BondtechAB/Voron/Voron_2.4-VT-SW/CPAP/README.md

# CPAP for Voron 2.4 and Stealthburner





## INSTRUCTIONS

Print in ASA or ABS

## BOM

*   3x M3x35 BHCS OR SHCS
*   2x M3x8 BHCS OR SHCS
*   2x M3x12 BHCS OR SHCS
*   2x M2x10 BHCS OR SHCS self tapping
*   7x M3x4 heatset insert
*   WS7040 and 15 mm CPAP hose
*   PC4-M10 Passthrough push fit connector
*   Some CA glue to attach the bowden passthrough

Thank you to criticaldistance for laying the foundation for the toolhead mod and giving me great ideas for implementation.

Also thanks to ByThorsThunder who made the elongated front for the SB. Find that here: https://github.com/VoronDesign/VoronUsers/tree/master/printer_mods/bythorsthunder/Stealthburner_Rapido_Uhf
