BondtechAB/Voron/Voron_2.4-VT-SW/LGX_lite/STL/SB _MOS/README.md

# Mosquito and Mosquito Magnum+ module

This contains custom x-carriages with our without square nut inserts, with native support for euclid and compatible with Voron Tap.







You can find the elongated SB front for Mosquito Magnum+ here, it's shared and compatible with Rapido UHF front: https://github.com/VoronDesign/VoronUsers/tree/master/printer_mods/bythorsthunder/Stealthburner_Rapido_Uhf

For the normal Mosquito you can use the standard SB front or variations thereof.

For use of Mosquito Magnum+ it's highly adviseable to use insulation around all sides of the block. In the directory SB_MOS-PLUS_SOCK you can find moulds for the block top and bottom. This may work printed with FDM, but for best results print with a resin printer and coat the resin to seal it in order to not inhibit the silicone curing.
