BondtechAB/Voron/Voron_2.4-VT-SW/LGX_lite/STL/SB-LGX_lite-Ebb36/README.md

# EBB36 module



## BOM

*   5x heatset inserts
*   2x M3x8 BHCS or SHCS
*   2x M3x30 BHCS or SHCS
*   1x M2x10 self tapping SHCS
*   1-2x PG7 spiral gland for CAN wiring
*   Optional 2510 24v fan with 4x M3x6. Tap the fan screw holes with an M3 tap, or let the screws cut threads. Source it from here: https://www.bondtech.se/product/mosquito-24v-fan-with-xhp-2-plug/
