BondtechAB/Voron/Voron_2.4-VT-SW/CPAP/STL frame/pcb holder.stl

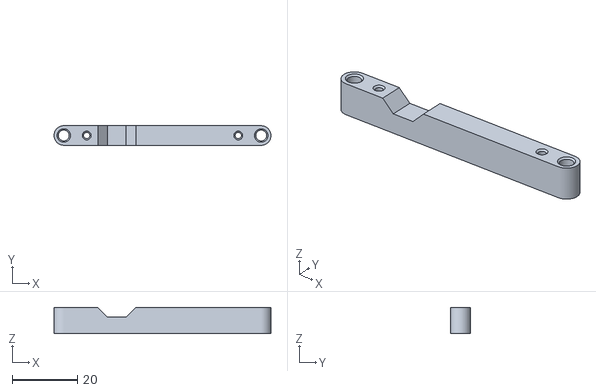
[picture p2: CAD file, 2024-01-02]
Voron_2.4-VT-SW/CPAP/STL frame/pcb holder.stl
66.3 x 6.01 x 8.00
