BondtechAB/Voron/Voron_2.4-VT-SW/LGX_lite/CAD/SB_MOS-PLUS_SOCK.step

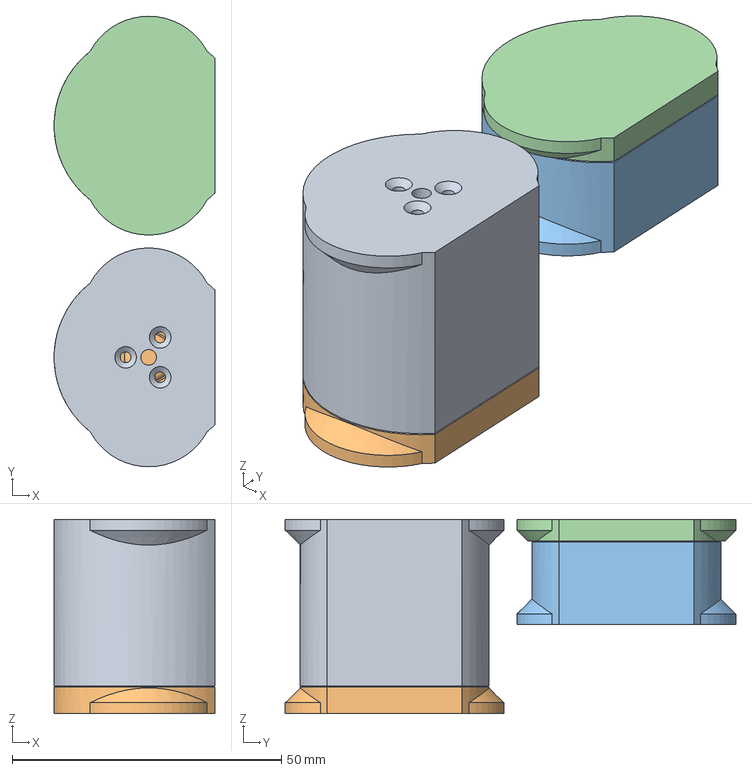
[picture p3: CAD file, 2024-01-09]
Voron_2.4-VT-SW/LGX_lite/CAD/SB_MOS-PLUS_SOCK.step
29.9 x 83.6 x 36.0 mm
