BondtechAB/Voron/Voron_2.4-VT-SW/LGX_lite/STL/LGX_lite-CW2-SB/lever_extender.stl

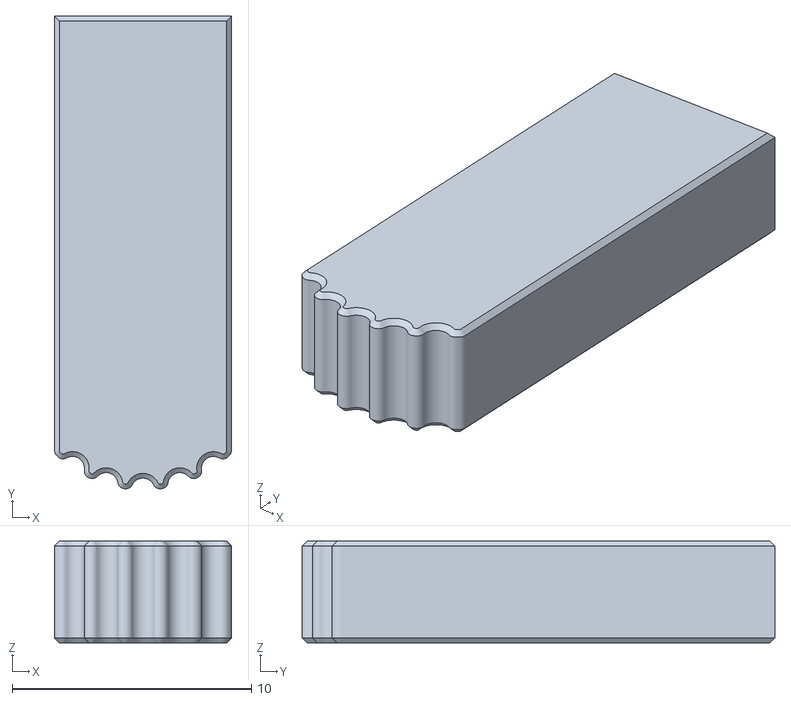
[picture p4: CAD file, 2024-01-09]
Voron_2.4-VT-SW/LGX_lite/STL/LGX_lite-CW2-SB/lever_extender.stl
7.40 x 19.8 x 4.25
