BondtechAB/Voron/Voron_2.4-VT-SW/LGX_lite/STL/SB _MOS/SB_MOS_Rear_CW2.stl

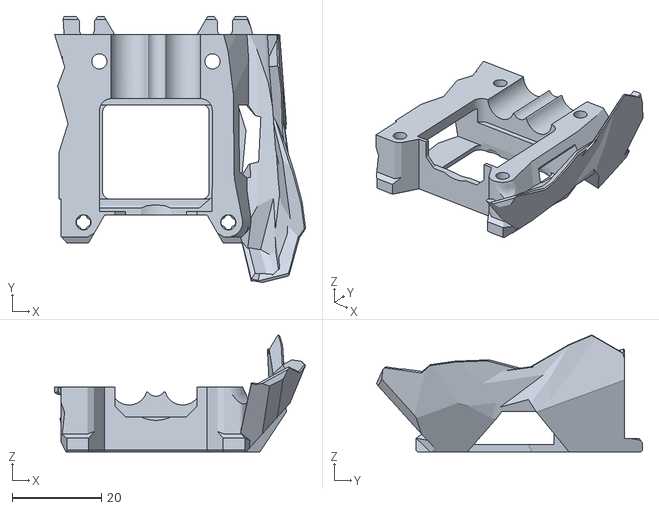
[picture p6: CAD file, 2024-01-02]
Voron_2.4-VT-SW/LGX_lite/STL/SB _MOS/SB_MOS_Rear_CW2.stl
56.3 x 59.7 x 26.3
