BondtechAB/Voron/Voron_2.4-VT-SW/CPAP/STL frame/back-cover.stl

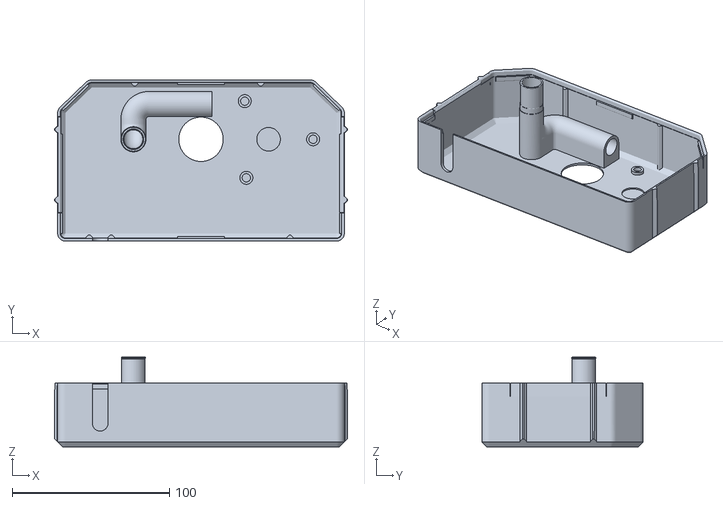
[picture p7: CAD file, 2024-01-02]
Voron_2.4-VT-SW/CPAP/STL frame/back-cover.stl
186.4 x 102.6 x 57.0
