BondtechAB/Voron/Voron_2.4-VT-SW/LGX_lite/CAD/LGX_lite-CW2-SB_FDM.step

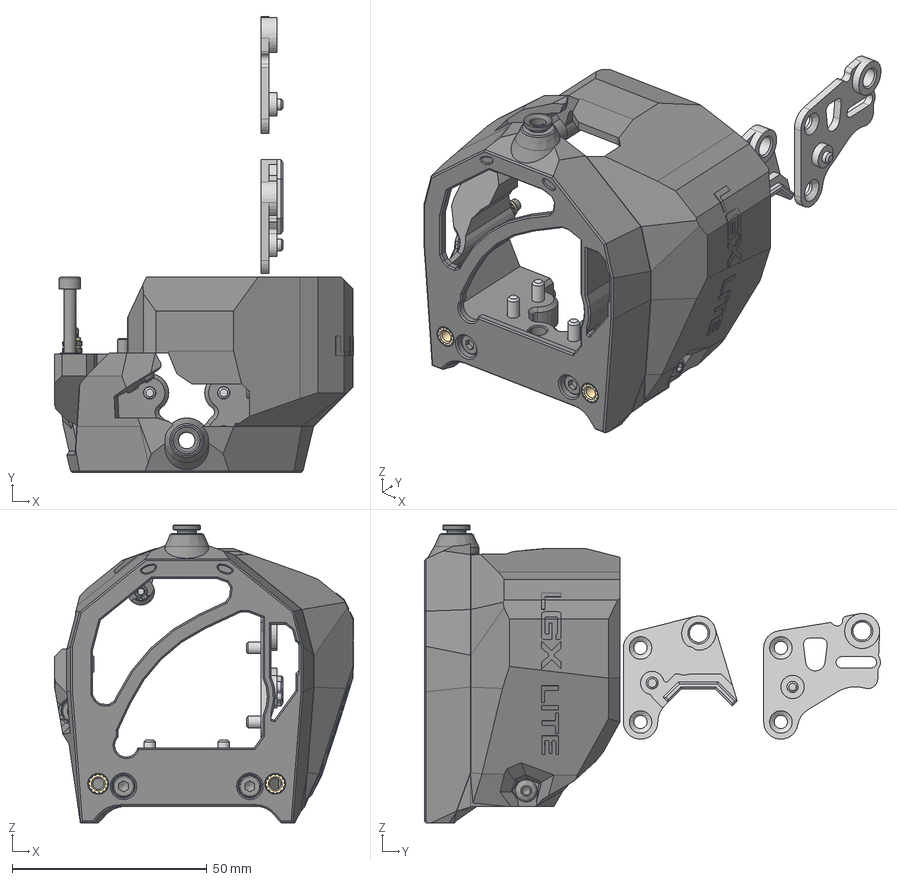
[picture p8: CAD file, 2024-01-02]
Voron_2.4-VT-SW/LGX_lite/CAD/LGX_lite-CW2-SB_FDM.step
76.8 x 117.0 x 76.3 mm
Collet
Hartk CW2 AB pcb mount
Hartk CW2 SB pcb mount
Hartk CW2 AB ERCF pcb mount
M3 Threaded Insert x 8
M3x30_SHCS (1) x 2
M3x8_SHCS
M3x16_SHCS x 2
ISO 7380-1 - M3 x 6
M3x20_SHCS
M3x30_SHCS
M3x6_FHCS x 2
M3x12_SHCS x 4
M3x6_SHCS
M3x10_SHCS
10100-05_StealthBurner_Main_Body_FDM
10100-06 StealthBurner PCB Cover
92605A114_NO THREADS_Stainless Steel Flat-Tip Set Screw
