BondtechAB/Voron/Voron_2.4-VT-SW/LGX_lite/STL/SB _MOS/x_frame_V2TR-mosquito_MGN12_left.stl

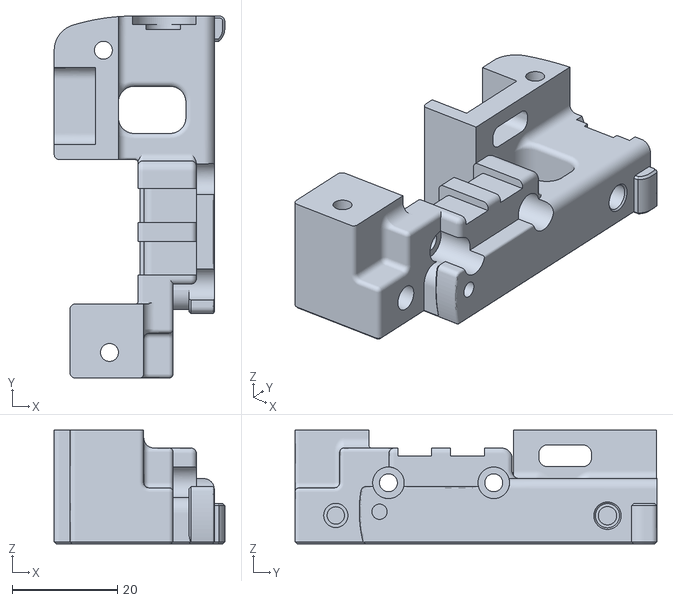
[picture p10: CAD file, 2024-01-02]
Voron_2.4-VT-SW/LGX_lite/STL/SB _MOS/x_frame_V2TR-mosquito_MGN12_left.stl
32.4 x 68.8 x 21.6
