BondtechAB/Voron/Voron_2.4-VT-SW/CPAP/STL frame/Cover.stl

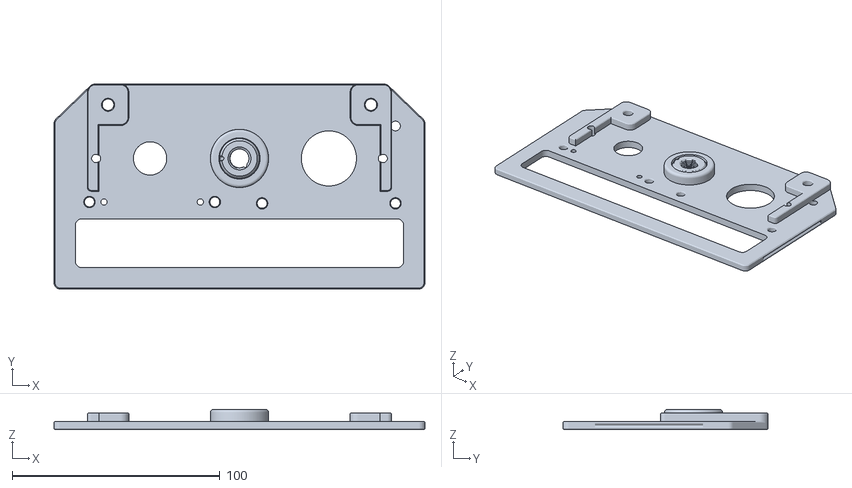
[picture p11: CAD file, 2024-01-02]
Voron_2.4-VT-SW/CPAP/STL frame/Cover.stl
178.4 x 98.6 x 9.70
