BondtechAB/Voron/Voron_2.4-VT-SW/LGX_lite/STL/SB-LGX_lite-Ebb36/Bondtech-ebb36_spacer_x2.stl

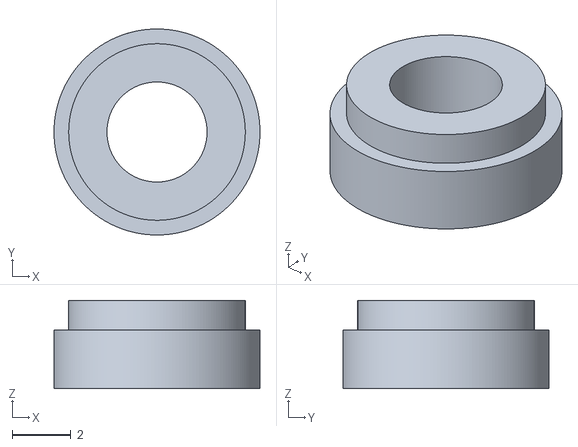
[picture p14: CAD file, 2023-01-23]
Voron_2.4-VT-SW/LGX_lite/STL/SB-LGX_lite-Ebb36/Bondtech-ebb36_spacer_x2.stl
7.00 x 7.00 x 3.00
