BondtechAB/Voron/Voron_2.4-VT-SW/CPAP/STL frame/ptfe-funnel.stl

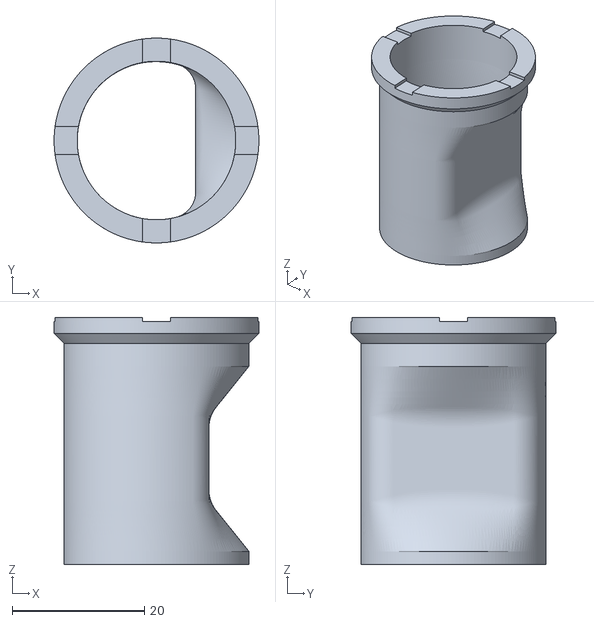
[picture p15: CAD file, 2024-01-02]
Voron_2.4-VT-SW/CPAP/STL frame/ptfe-funnel.stl
31.0 x 31.0 x 37.4
