BondtechAB/Voron/Voron_2.4-VT-SW/CPAP/STL toolhead/SB-CPAP_hose-mount.stl

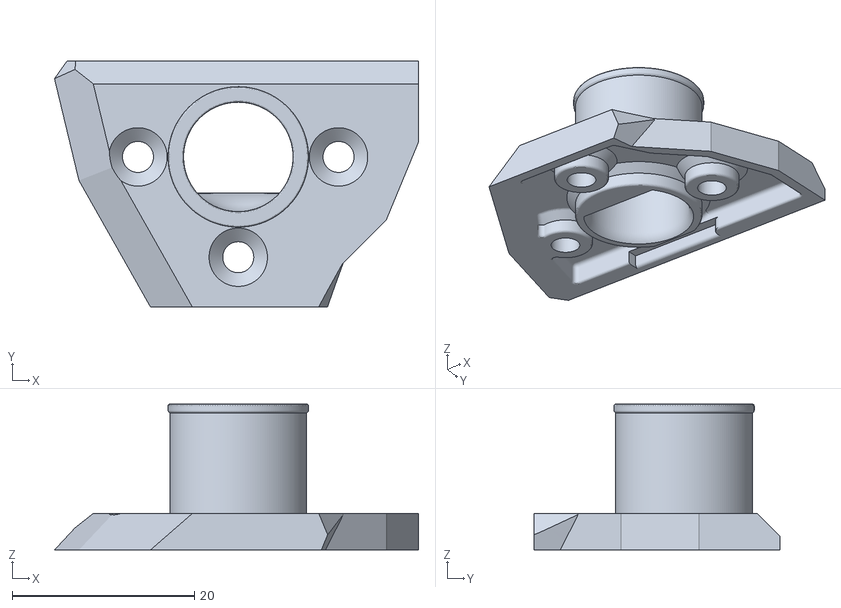
[picture p16: CAD file, 2024-01-02]
Voron_2.4-VT-SW/CPAP/STL toolhead/SB-CPAP_hose-mount.stl
39.9 x 27.0 x 16.0
