BondtechAB/Voron/Voron_2.4-VT-SW/LGX_lite/STL/SB _MOS/SB _MOS-PLUS_Front.stl

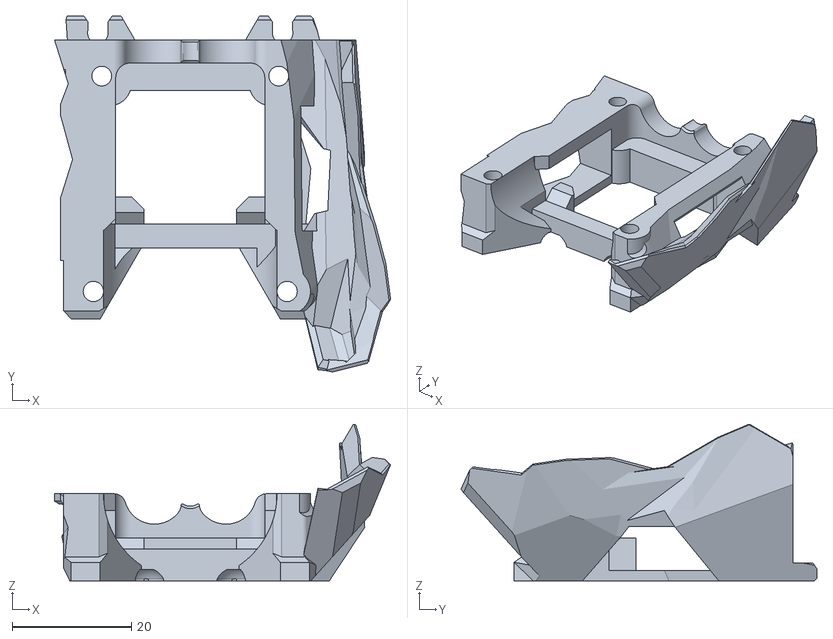
[picture p17: CAD file, 2023-01-23]
Voron_2.4-VT-SW/LGX_lite/STL/SB _MOS/SB _MOS-PLUS_Front.stl
56.4 x 59.7 x 26.3
