BondtechAB/Voron/Voron_2.4-VT-SW/LGX_lite/STL/SB _MOS/SB_MOS-PLUS_SOCK/SB_MOS-PLUS_SOCK_TOP_SHAPE.stl

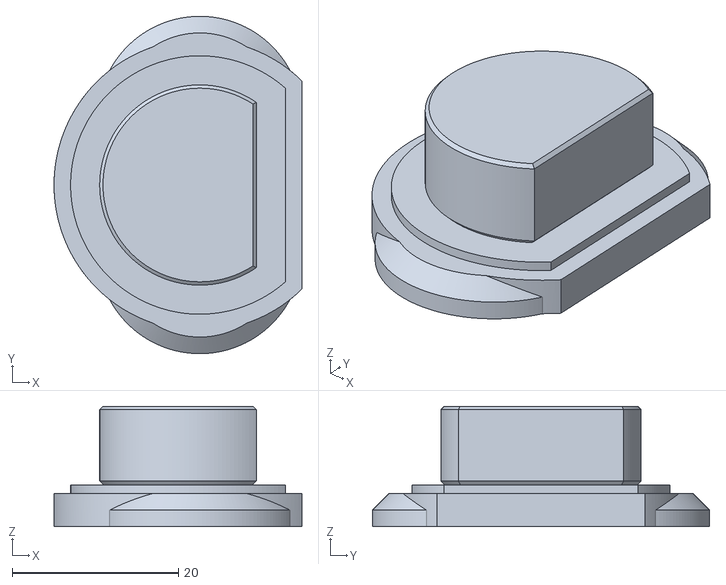
[picture p18: CAD file, 2024-01-09]
Voron_2.4-VT-SW/LGX_lite/STL/SB _MOS/SB_MOS-PLUS_SOCK/SB_MOS-PLUS_SOCK_TOP_SHAPE.stl
29.9 x 40.6 x 14.5
