BondtechAB/Voron/Voron_2.4-VT-SW/CPAP/STL frame/Grill.stl

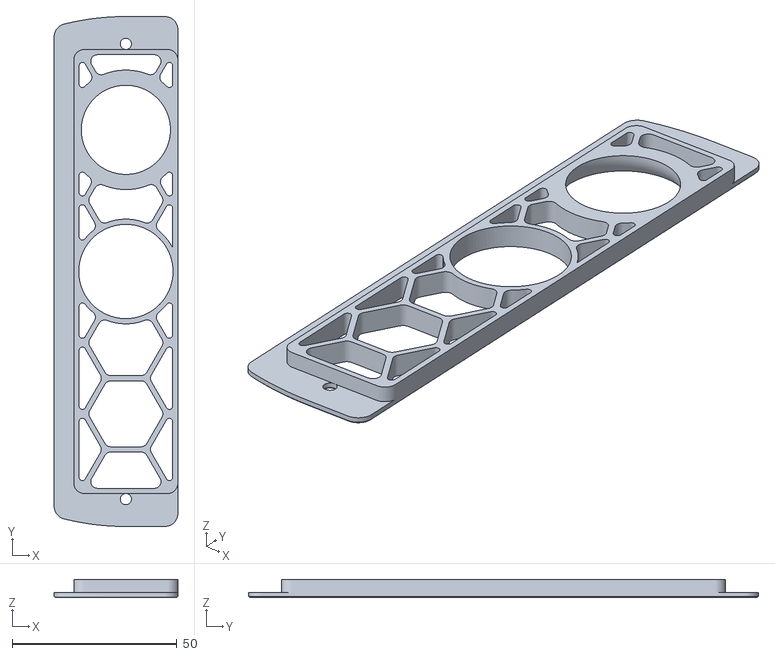
[picture p19: CAD file, 2024-01-02]
Voron_2.4-VT-SW/CPAP/STL frame/Grill.stl
37.6 x 154.8 x 5.60
