BondtechAB/Voron/Voron_2.4-VT-SW/LGX_lite/STL/LGX_lite-CW2-SB/Hartk_CW2_AB_ERCF_pcb_mount.stl

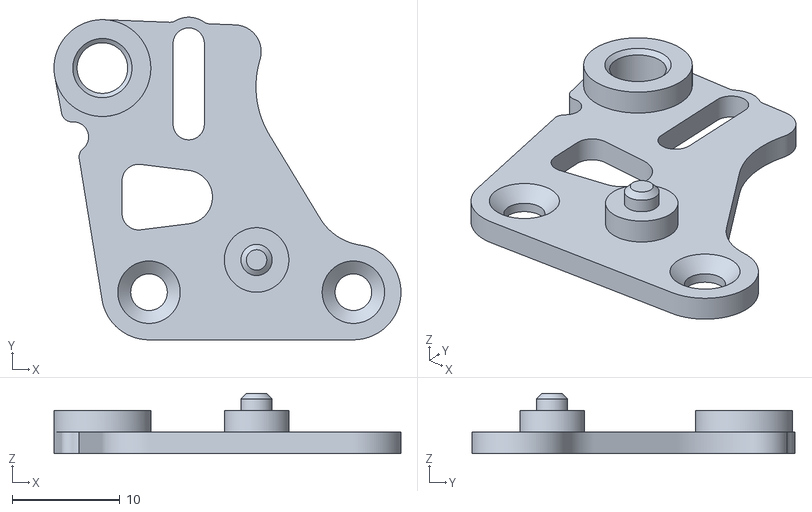
[picture p20: CAD file, 2023-01-23]
Voron_2.4-VT-SW/LGX_lite/STL/LGX_lite-CW2-SB/Hartk_CW2_AB_ERCF_pcb_mount.stl
32.3 x 30.0 x 5.60
