BondtechAB/Voron/Voron_2.4-VT-SW/LGX_lite/STL/SB _MOS/euclid_probe_mount.stl

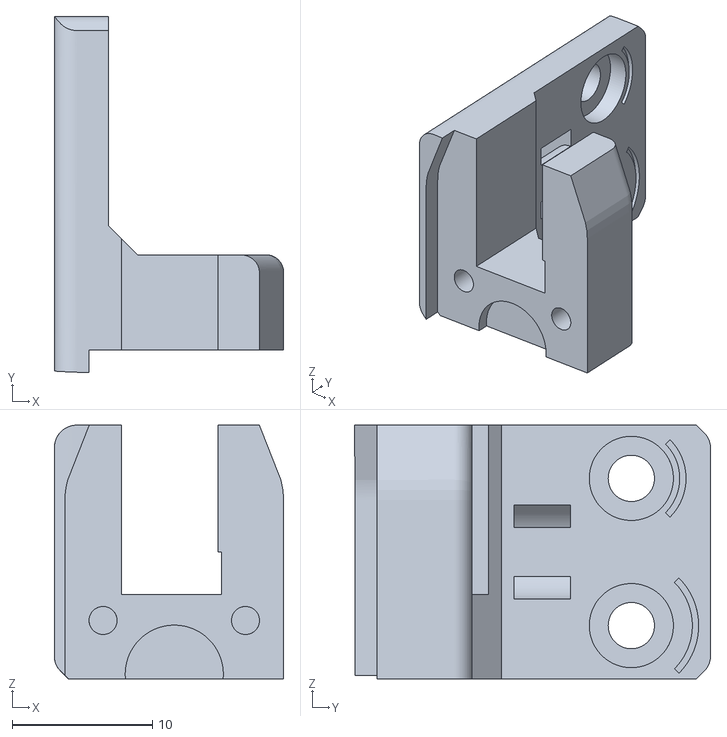
[picture p22: CAD file, 2023-01-23]
Voron_2.4-VT-SW/LGX_lite/STL/SB _MOS/euclid_probe_mount.stl
16.4 x 25.4 x 18.1
