BondtechAB/Voron/Voron_2.4-VT-SW/LGX_lite/STL/LGX_lite-CW2-SB/Hartk_CW2_SB_pcb_mount.stl

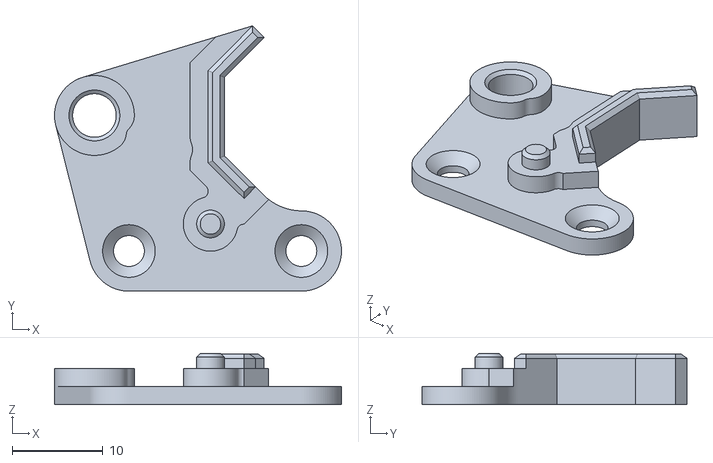
[picture p23: CAD file, 2023-01-23]
Voron_2.4-VT-SW/LGX_lite/STL/LGX_lite-CW2-SB/Hartk_CW2_SB_pcb_mount.stl
31.6 x 29.2 x 5.65
