BondtechAB/Voron/Voron_2.4-VT-SW/LGX_lite/STL/LGX_lite-CW2-SB/ptfe_cutting_jig.stl

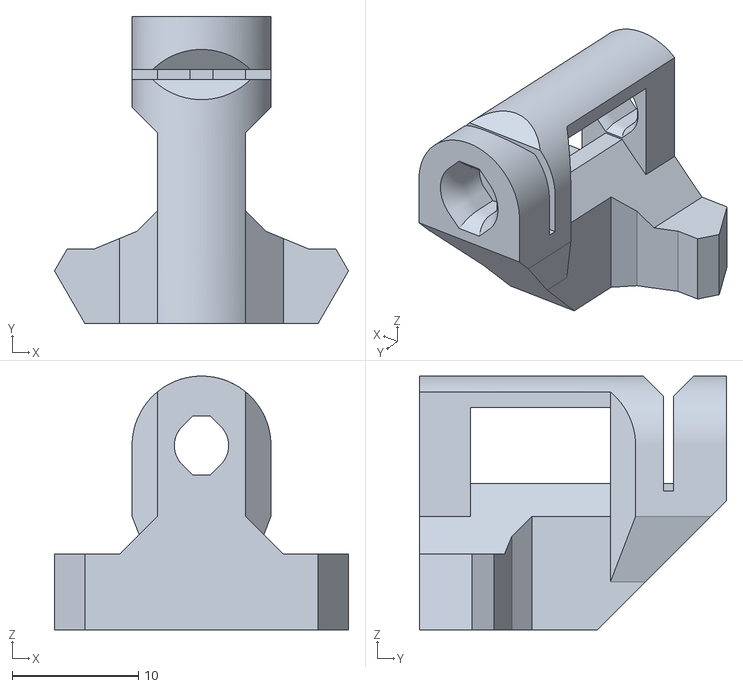
[picture p24: CAD file, 2023-01-23]
Voron_2.4-VT-SW/LGX_lite/STL/LGX_lite-CW2-SB/ptfe_cutting_jig.stl
23.3 x 24.3 x 20.1
