BondtechAB/Voron/(list of files, cad)

Other CAD files:
Voron_2.4-VT-SW/CPAP/STL toolhead/10100-04_StealthBurner_Front_CPAP_MOS-PLUS_FDM.stl
Voron_2.4-VT-SW/CPAP/STL toolhead/10100-19_StealthBurner_Cam_Module.stl
Voron_2.4-VT-SW/CPAP/STL toolhead/10100-20_StealthBurner Cam_Holder.stl
Voron_2.4-VT-SW/CPAP/STL toolhead/10100-22_StealthBurner_CPAP_PCB_Cover.stl
Voron_2.4-VT-SW/LGX_lite/STL/LGX_lite-CW2-SB/10100-05_StealthBurner_Main_Body_FDM.stl
Voron_2.4-VT-SW/LGX_lite/STL/LGX_lite-CW2-SB/10100-06_StealthBurner_PCB_Cover-FDM.stl
Voron_2.4-VT-SW/LGX_lite/STL/LGX_lite-CW2-SB/10100-07_StealthBurner_EBB36 PG7_Mount_nosupport-FDM.stl
Voron_2.4-VT-SW/LGX_lite/STL/LGX_lite-CW2-SB/10100-07_StealthBurner_EBB36 PG7_Mount_supported-FDM.stl
Voron_2.4-VT-SW/LGX_lite/STL/SB _MOS/x_frame_V2TR-mosquito_MGN12_left-square_nut.stl
Voron_2.4-VT-SW/LGX_lite/STL/SB _MOS/x_frame_V2TR-mosquito_MGN12_right-square_nut.stl
Voron_2.4-VT-SW/LGX_lite/STL/SB-LGX_lite-Ebb36/10100-08_StealthBurner_EBB36_PCB_Cover-FDM.stl
Voron_2.4-VT-SW/LGX_lite/STL/SB-LGX_lite-Ebb36/10100-09_StealthBurner_EBB36_PCB_Cover_Back-FDM.stl
