BondtechAB/Voron/(threads)

Thread 1 (2023-01-26):

Missing SB-front_MOS in STEP; Missing STLs for SB-front_MOS and SB-front_MOS-PLUS

eduncan911, 2023-01-26:
First! j/k

For the **LGX Lite for Voron CW2 Stealthburner**, the STEP file is missing the non-CPAP Front cover (I think they should be called "frontcover" instead of "front", as there are two fronts for the PLUS.

https://github.com/BondtechAB/Voron/blob/main/Voron_2.4-VT-SW/LGX_lite/CAD/Bondtech-LGX_lite-stealthburner.step

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

eduncan911, 2023-01-26:
And... It looks like the STLs for both the SB-front_MOS-PLUS, and the reported missing object in OP, are both missing from the STL directory:

https://github.com/BondtechAB/Voron/tree/main/Voron_2.4-VT-SW/LGX_lite/STL/SB%20_MOS

ogland, 2023-01-27:
Hi! Mosquito uses the same cover as standard SB. The SB front is found at the credits: [https://github.com/VoronDesign/VoronUsers/tree/master/printer_mods/bythorsthunder/Stealthburner_Rapido_Uhf](https://github.com/VoronDesign/VoronUsers/tree/master/printer_mods/bythorsthunder/Stealthburner_Rapido_Uhf)

I'll make this more clear in the readme.

eduncan911, 2023-01-27:
Ok, great.  That covers (phun) the non-PLUS.

However, that just leaves the STL export of the PLUS front cover, as originally reported in the OP.

eduncan911, 2023-01-27:
Updated the Title, and 2nd post for what's remaining.

Also, could you re-open until the README is updated and the STL posted?

ogland, 2023-01-27:
The STL won't be uploaded. It's available in the repo linked to in the readme.

Closed 2023-01-27.

Thread 2 (2023-01-26):

[Talk] Design Considerations

eduncan911, 2023-01-26:
Thank you for posting this design.  I've been tinkering with LGX Lite designs, trying to make something work with my custom VolcoMosq setup (which uses the Mosquito's Radiator/Heatsink and mount).  This design gets close, however, there's still significant work.  I'll see what I can do about merging the two designs (maybe a PR).

I would like to ask about the design considerations in this project for certain features.

## 1. **Hotend Fan Ducting - Fully encapsulating the Mosquito's Radiator/Heatsink**

This is unusual; but, very cool!  The duct-work of how the air is shaped and then compressed down into shape of the heatsink, forces all air over the heatbreak where nothing escapes over the sides.  Very clever.

I am inquiring about how well this has been tested, and to what temps.  My concern is that the heatsink itself was designed for free-air cooling from a low-speed fan, with airflow over the entire heatsink.  But encapsulating the entire heatsink, to where even the sides are not exposed, is new.

## 2. **Heater-block Melting?**

The Mosquito's and Magnum (non-plus) are notorious for melting cooling ducts and x-carriages due to its large, wide design and cooling ducts that want to reach around the heatsink.

When I placed a Mosquito in the CAD, it shows that the heater-block is partially encapsulated/very close to the top of the block for the rear mounts.

How well has this been tested, and at what temps for what periods of time?  Unless the "Front/Rear" and X-Carriage parts are all printed in PC6+CF, I can't see how this won't melt - and very quickly.

ogland, 2023-01-27:
Hi! The solution works quite well with a full encapsulating silicone sock. I'm working with Slice to see what the best solution is. But for now I think I will add the moulds for DIYers to make their own. Thanks for your input!

eduncan911, 2023-01-27:
What were the printing temps, and how many hours does that printer have on it?

Could you give details?  "Works quite well" is not very specific to the details asked.

ogland, 2023-01-27:
I have printed at 270C hotend temp for a couple of days, with the longest print so far being 5 hours. No deformation.

eduncan911, 2023-08-26:
No idea.  I'd say whichever keeps it away from the plastic.  :)

sorry i didn't close this out before.

Closed 2023-08-26.

Thread 3 (2023-01-26):

Missing Print Instructions - SLS Only?

eduncan911, 2023-01-26:
I am not seeing a clean way to print a part, such as the `SB_MOS-PLUS_Front`.

The internal duct-work seems impossible to 3D print on SLA nor FDM.  Seems you can only do this with SLS?

[Peek 2023-01-25 21-20.webm](https://user-images.githubusercontent.com/104980/214743745-cba041b9-cf6e-4b22-bdb2-08b547f2c9e5.webm)

eduncan911, 2023-01-26:
Apologies, I see the shape of the ducts now and how printing it face-down is the best way for 45 degree overhangs.  nice

Closed 2023-01-26.

Thread 6 (2023-03-24):

Both SB_MOS STLs are for Square nuts

3DLabTech, 2023-03-24:
Both the STL files look like they are for square nuts in the SB_MOS folder.
There doesn't seem to be an STL file for the heat set inserts version.

I am having a lot of problems getting the square nuts to fit. What size is recommended?

Thread 7 (2023-05-16):

Mosquito without LGX

TigerClaw33, 2023-05-16:
Hi,

I am new with Voron. Is there a version which can be used wihtout the LGX Light? I would like to use first the SW2 in my Voron 2.4 R2 Kit with Mosquito or Mosquito+. One reason is because I want to continue with direct extruder and not changing to bowden.

Best regards,
Mike

geoffdavis, 2024-02-26:
@TigerClaw33 you can just use the lower body parts of the mosquito toolhead in this repository. Stealthburner is modular, and the LGX lite parts replace the upper Clockwork2 extruder only.

Thread 9 (2023-10-31):

Bondtech-LGX lite pcb cover Ebb3 back

Bata3, 2023-10-31:
Hi, I really like the design, but I have a problem with the back cover of the PCB. I ordered the optional fan 2507, but it is too high and the back cover cannot be attached to the body. When I looked at the CAD file, at one point the height is only 5.158 mm, which is not enough when the fan is 7 mm. Can the model be modified to fit? Thank you very much
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

Thread 10 (2024-09-18):

Missing stl files for mounting CPAP fan?

Nihont0, 2024-09-18:
I cannot find the stl files for mounting CPAP fan while they are visible on the readme file cad drawing.

Madz3, 2024-09-21:
hey @Nihont0 is this what you are looking for?
https://github.com/ogland/Printer-mods/tree/main/V2/CPAP
