BondtechAB/Voron/(commit log)

2023-01-23 Create repo
    [Bondtech-LGX_lite_pcb_cover.stl, Bondtech-LGX_lite_pcb_cover_Ebb36-back.stl, Bondtech-LGX_lite_pcb_cover_Ebb36.stl, Bondtech-ebb36-pg7-lgx_lite-no_support-sls.stl, Bondtech-ebb36-pg7-lgx_lite.stl, Hartk_CW2_AB_ERCF_pcb_mount.stl, Hartk_CW2_AB_pcb_mount.stl, Hartk_CW2_SB_pcb_mount.stl]
2023-01-23 Folder naming
    [Bondtech-LGX_lite_pcb_cover.stl, Bondtech-LGX_lite_pcb_cover_Ebb36-back.stl, Bondtech-LGX_lite_pcb_cover_Ebb36.stl, Bondtech-ebb36-pg7-lgx_lite-no_support-sls.stl, Bondtech-ebb36-pg7-lgx_lite.stl, Hartk_CW2_AB_ERCF_pcb_mount.stl, Hartk_CW2_AB_pcb_mount.stl, Hartk_CW2_SB_pcb_mount.stl]
2023-01-23 Adding parts, updating CAD
    [Bondtech-ebb36_spacer_x2.stl, spacer_x2.stl]
2023-01-24 Ebb36 fan geometry fixed
    [Bondtech-LGX_lite_pcb_cover_Ebb36-back.stl, Bondtech-ebb36-pg7-lgx_lite.stl]
2023-01-27 Adding silicone sock moulds and documentation
    [SB_MOS-PLUS_SOCK.step, SB_MOS-PLUS_SOCK_SHIELD-SHAPE.stl, SB_MOS-PLUS_SOCK_SHIELD_OUTER.stl, SB_MOS-PLUS_SOCK_TOP_OUTER.stl, SB_MOS-PLUS_SOCK_TOP_SHAPE.stl]
2024-01-02 Consolidating files, updates, CPAP merge
    Readme will be updated shortly
    [10100-04_StealthBurner_Front_CPAP_MOS-PLUS_FDM.stl, 10100-05_StealthBurner_Main_Body_FDM.stl, 10100-06_StealthBurner_PCB_Cover-FDM.stl, 10100-07_StealthBurner_EBB36 PG7_Mount_nosupport-FDM.stl, 10100-07_StealthBurner_EBB36 PG7_Mount_supported-FDM.stl, 10100-08_StealthBurner_EBB36_PCB_Cover-FDM.stl, 10100-09_StealthBurner_EBB36_PCB_Cover_Back-FDM.stl, 10100-19_StealthBurner_Cam_Module.stl]
2024-01-09 Renewing sock design, orientation of lever extender
    [SB_MOS-PLUS_SOCK_BOTTOM.stl, SB_MOS-PLUS_SOCK_BOTTOM_SHAPE.stl, SB_MOS-PLUS_SOCK_SHIELD-SHAPE.stl, SB_MOS-PLUS_SOCK_SHIELD_OUTER.stl, SB_MOS-PLUS_SOCK_TOP_OUTER.stl, SB_MOS-PLUS_SOCK_TOP_SHAPE.stl, lever_extender.stl]
